epsilonrt/NanoPiCore4DinBox/extras/images/gparted.png

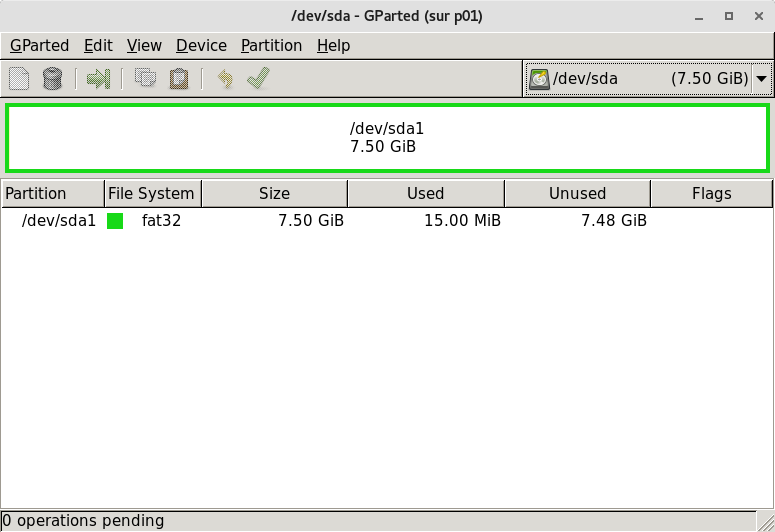
extras/images/gparted.png
