epsilonrt/NanoPiCore4DinBox/extras/images/proteus-3d.png

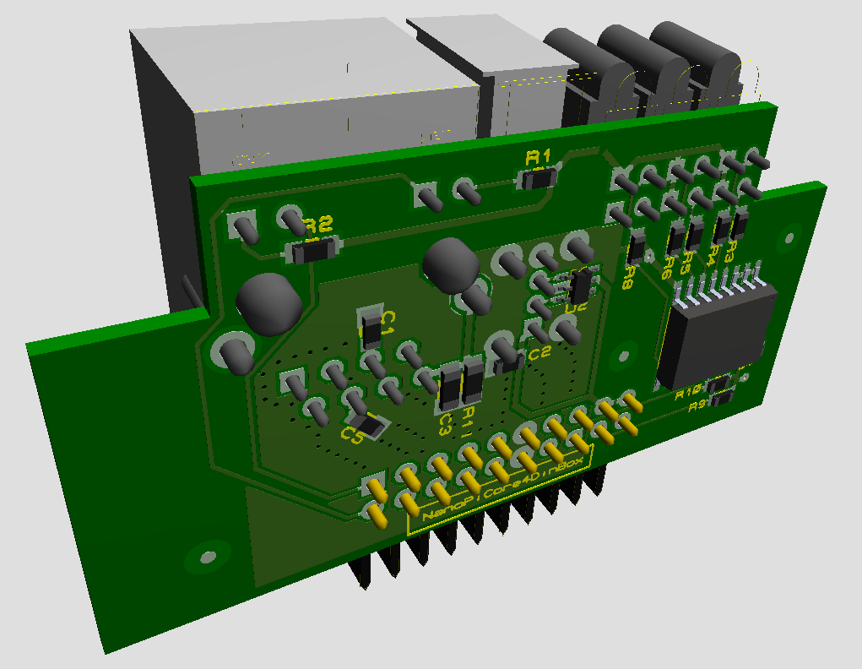
extras/images/proteus-3d.png
