epsilonrt/NanoPiCore4DinBox/extras/images/usb.jpg

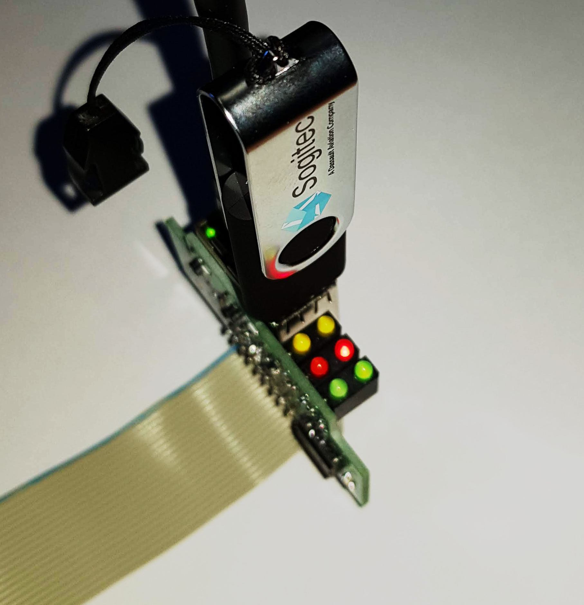
extras/images/usb.jpg
