epsilonrt/NanoPiCore4DinBox/hardware/pcb-pool/BDE5c9dcdb48f4f8_01_seite2.jpg

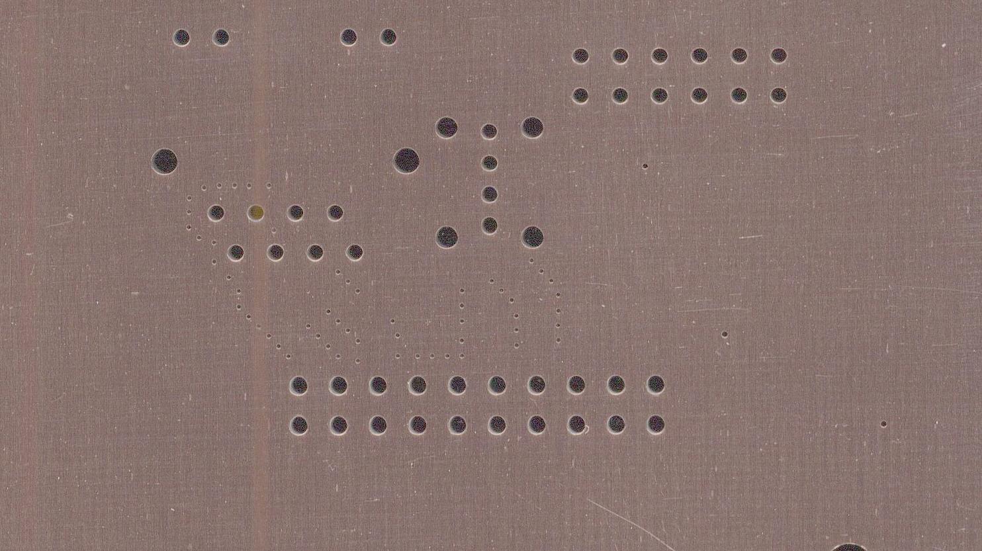
hardware/pcb-pool/BDE5c9dcdb48f4f8_01_seite2.jpg
