epsilonrt/NanoPiCore4DinBox/hardware/pcb-pool/BDE5c9e027b1d25a_02_seite1.jpg

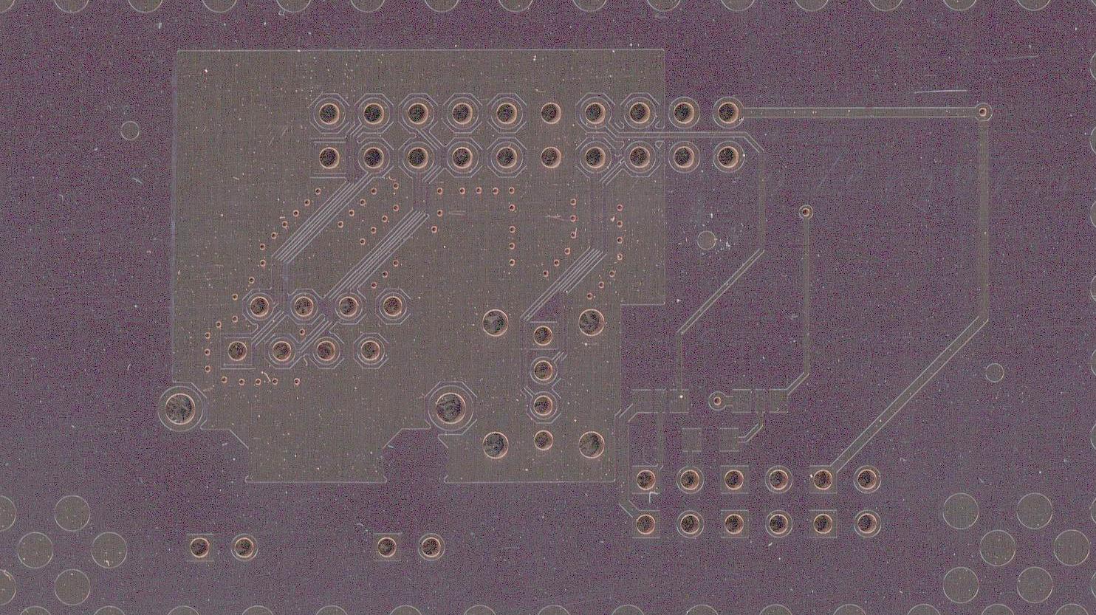
hardware/pcb-pool/BDE5c9e027b1d25a_02_seite1.jpg
