epsilonrt/NanoPiCore4DinBox/hardware/pcb-pool/BDE5c9e027b1d25a_02_seite2.jpg

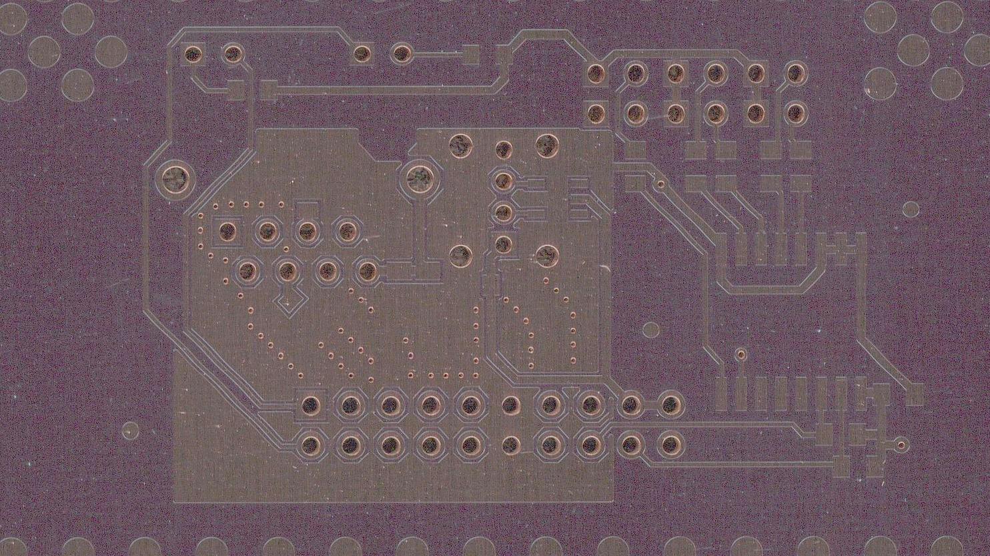
hardware/pcb-pool/BDE5c9e027b1d25a_02_seite2.jpg
