epsilonrt/NanoPiCore4DinBox/hardware/NanoPiCore4Dinbox-bom.html

Bill Of Materials For NanoPiCore4Dinbox
Design Title | : | NanoPiCore4Dinbox
Author | :
Revision | : | 1.02
Design Created | : | vendredi 1 mars 2019
Design Last Modified | : | vendredi 15 mars 2019
Total Parts In Design | : | 26
11 Resistors
 | Quantity: |  | References | Value | Package
 | 2 |  | R1, R2 | 330R | 0805
 | 6 |  | R3-R8 | 680R | 0805
 | 2 |  | R9, R10 | 1k8 | 0805
 | 1 |  | R11 | 1M | 1206
5 Capacitors
 | Quantity: |  | References | Value | Package
 | 3 |  | C1, C4, C5 | 100nF | 0805
 | 1 |  | C2 | 10uF | 0805
 | 1 |  | C3 | 1nF | 1206
2 Integrated Circuits
 | Quantity: |  | References | Value | Package
 | 1 |  | U1 | PCF8574 | SO16W
 | 1 |  | U2 | USBLC6-4 | SOT457
3 Diodes
 | Quantity: |  | References | Value | Package
 | 1 |  | D1 | 553-0222 | LED-CBI-553-XXXX
 | 1 |  | D2 | 553-0211 | LED-CBI-553-XXXX
 | 1 |  | D3 | 553-0233 | LED-CBI-553-XXXX
5 Miscellaneous
 | Quantity: |  | References | Value | Package
 | 1 |  | J1 | NANOPI-NEO-CORE-NET | CONN-2X10-HE14-C
 | 1 |  | J2 | HR-911105A | CONN-8-RJ45-HR-911105A
 | 1 |  | J3 | USB4 | CON-4-USBAF-MO-48204-0001
 | 2 |  | JP1, JP2 | JUMPER2 | 0805-JUMPER2
mercredi 1 janvier 2020 16:59:12
