epsilonrt/NanoPiCore4DinBox/hardware/NanoPiCore4Dinbox-sch.pdf

0

1

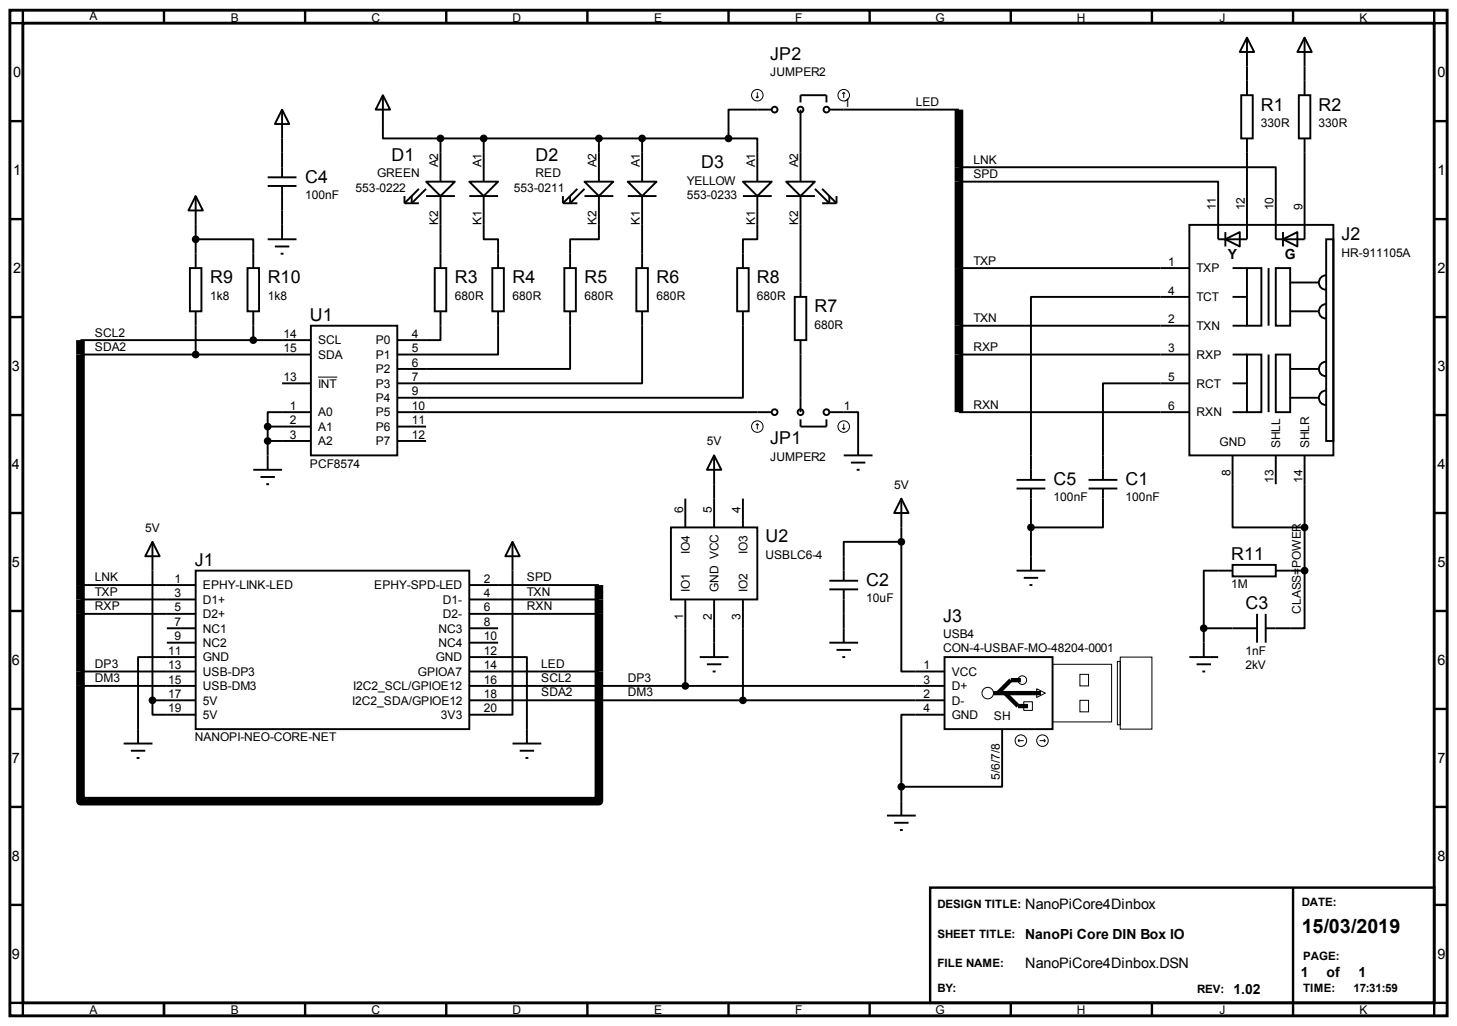
[picture p18: page 1]

NANOPI-NEO-CORE-NET

NanoPi Core DIN Box IO
