epsilonrt/NanoPiCore4DinBox/hardware/templates/CAMDENBOSS-CNMB4-2.pdf

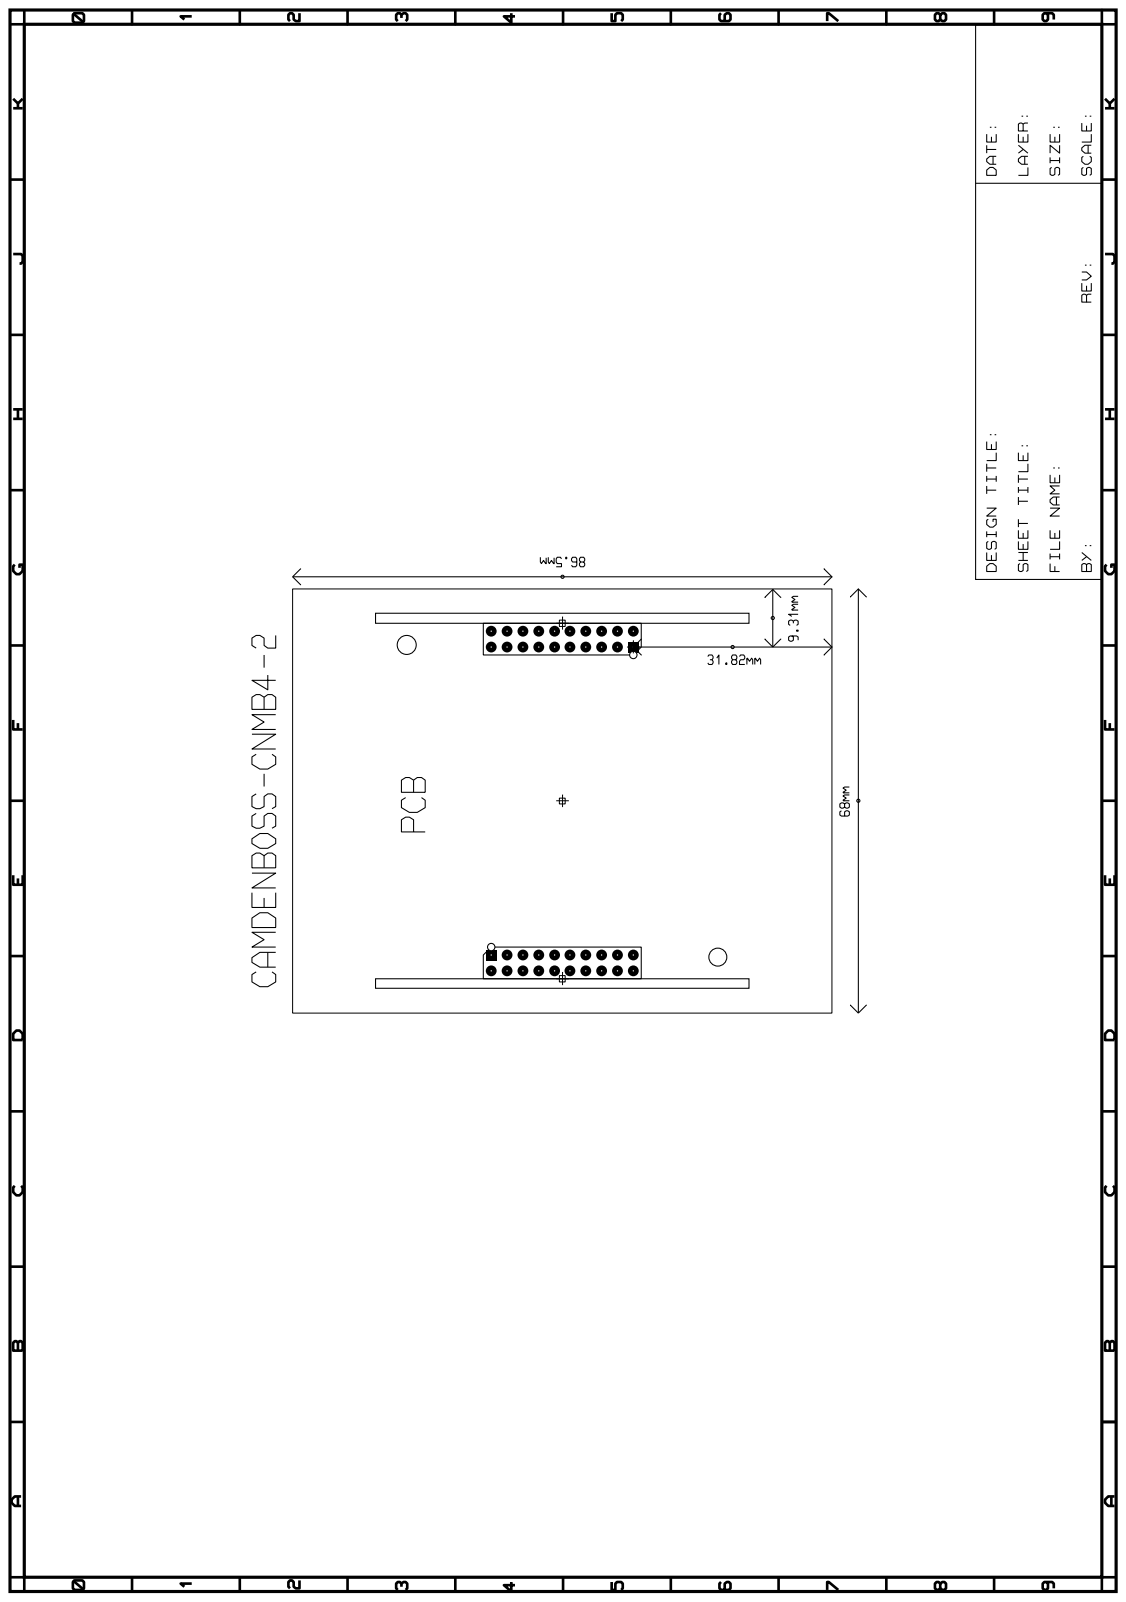
[picture p19: page 1]
