epsilonrt/NanoPiCore4DinBox/hardware/pcb-pool/r13591(t7).pdf

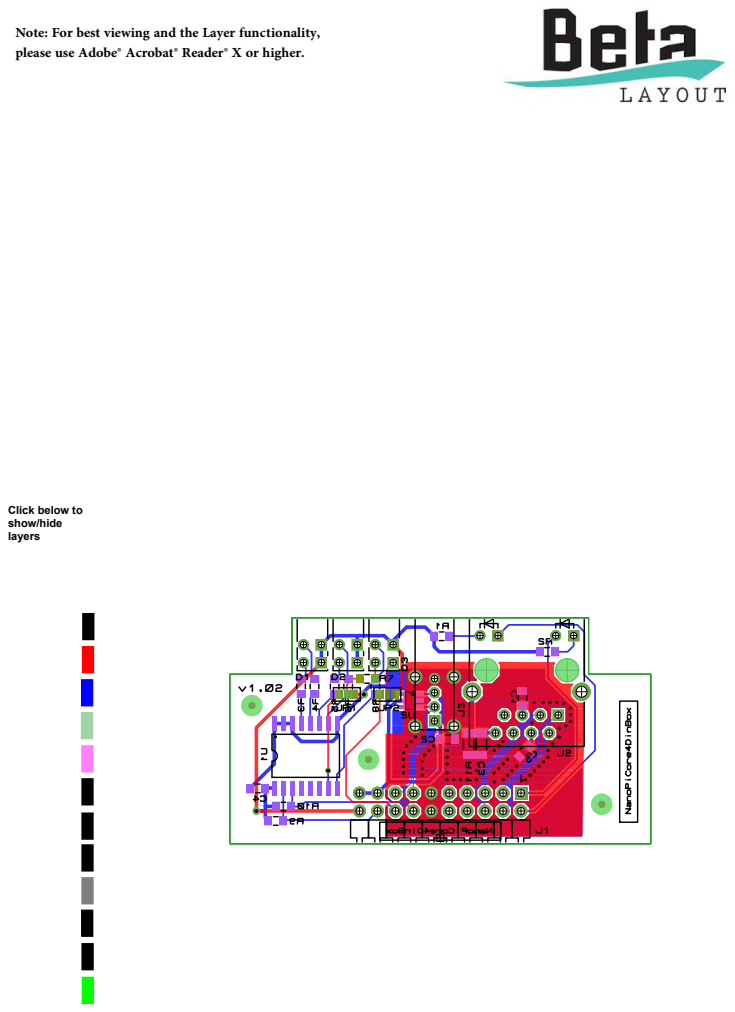
[picture p20: page 1]

Note: For best viewing and the Layer functionality,
please use Adobe® Acrobat® Reader® X or higher.
