epsilonrt/NanoPiCore4DinBox/(list of files, drawings)

Other design files:
hardware/NanoPiCore4Dinbox.DSN
hardware/NanoPiCore4Dinbox.LYT
hardware/v1.1/NanoPiCore4Dinbox.DSN
hardware/v1.1/NanoPiCore4Dinbox.LYT
