epsilonrt/NanoPiCore4DinBox/(commit log)

2020-01-05 Update images and hardware
    [NanoPiCore4Dinbox.DSN, NanoPiCore4Dinbox.LYT]
2020-01-05 Update PCB to v1.11
    [NanoPiCore4Dinbox.DSN, NanoPiCore4Dinbox.LYT]
